CodeMakesItGo/ChickenCoopDoor/PowerSupplyVias.png

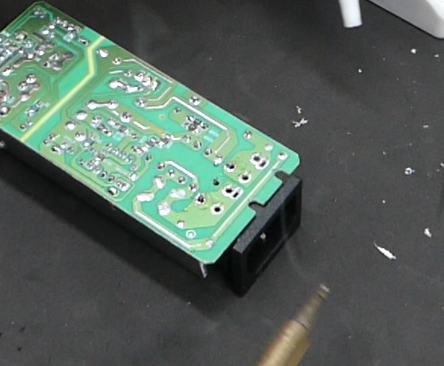
PowerSupplyVias.png
