CodeMakesItGo/ChickenCoopDoor/Garage Unit with 120v Power Connection.png

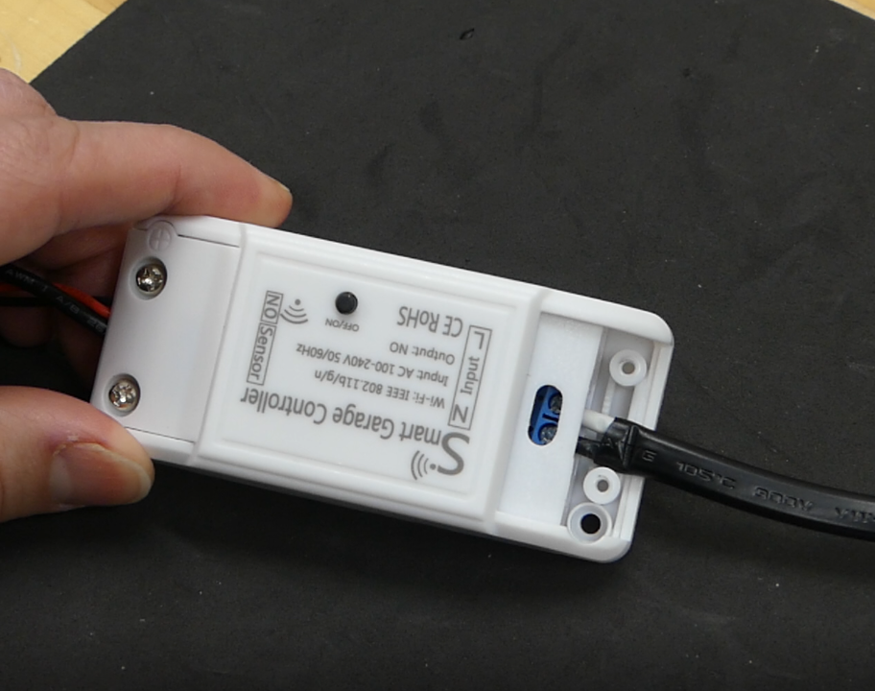
Garage Unit with 120v Power Connection.png
