CodeMakesItGo/ChickenCoopDoor/5V Relay Connections.PNG

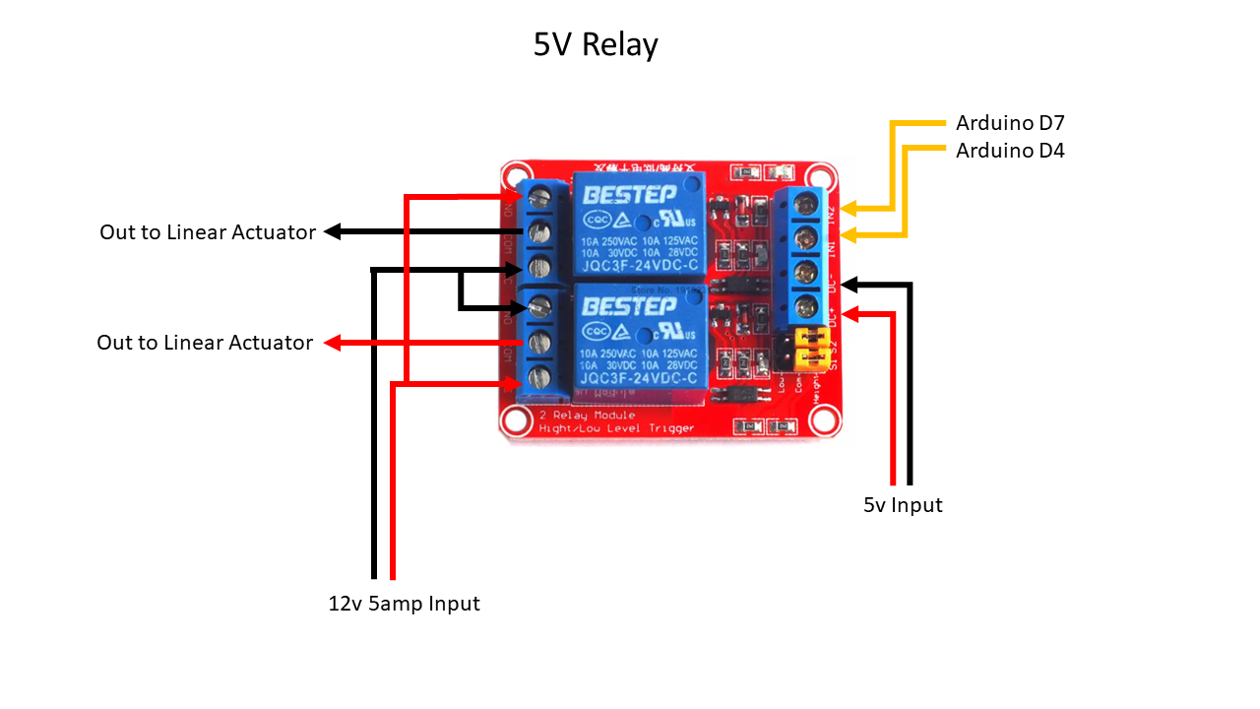
5V Relay Connections.PNG
