CodeMakesItGo/ChickenCoopDoor/5V USB Controller with 5V Relay.PNG

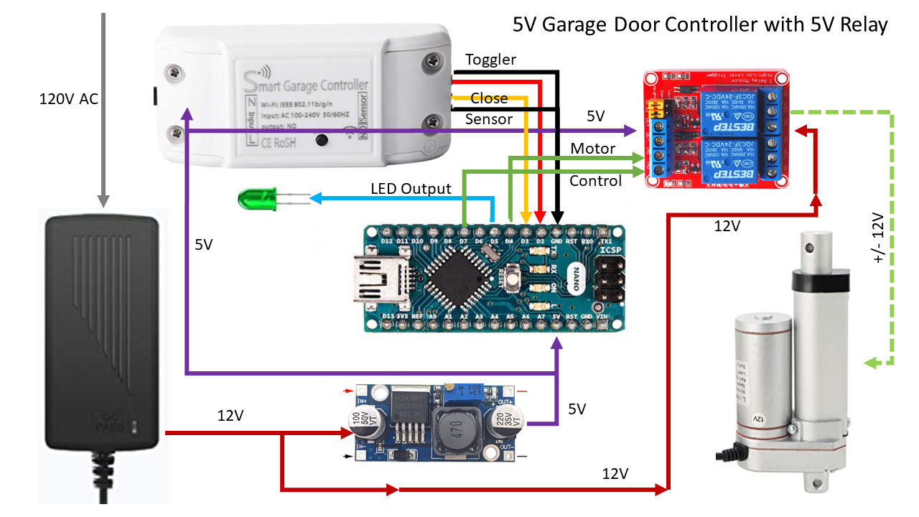
5V USB Controller with 5V Relay.PNG
