CodeMakesItGo/ChickenCoopDoor/120V Controller with 5V Relay.PNG

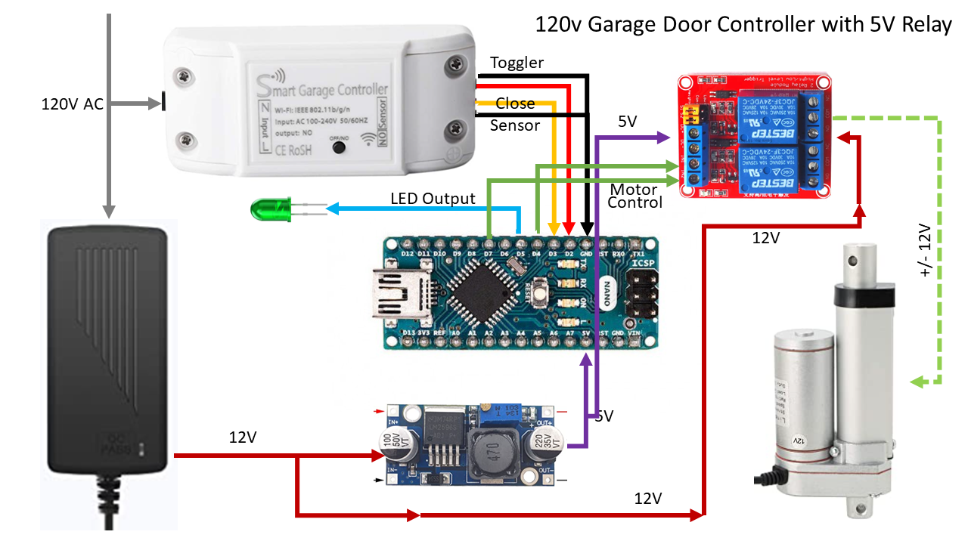
120V Controller with 5V Relay.PNG
