CodeMakesItGo/ChickenCoopDoor/Feedback sensor connection.PNG

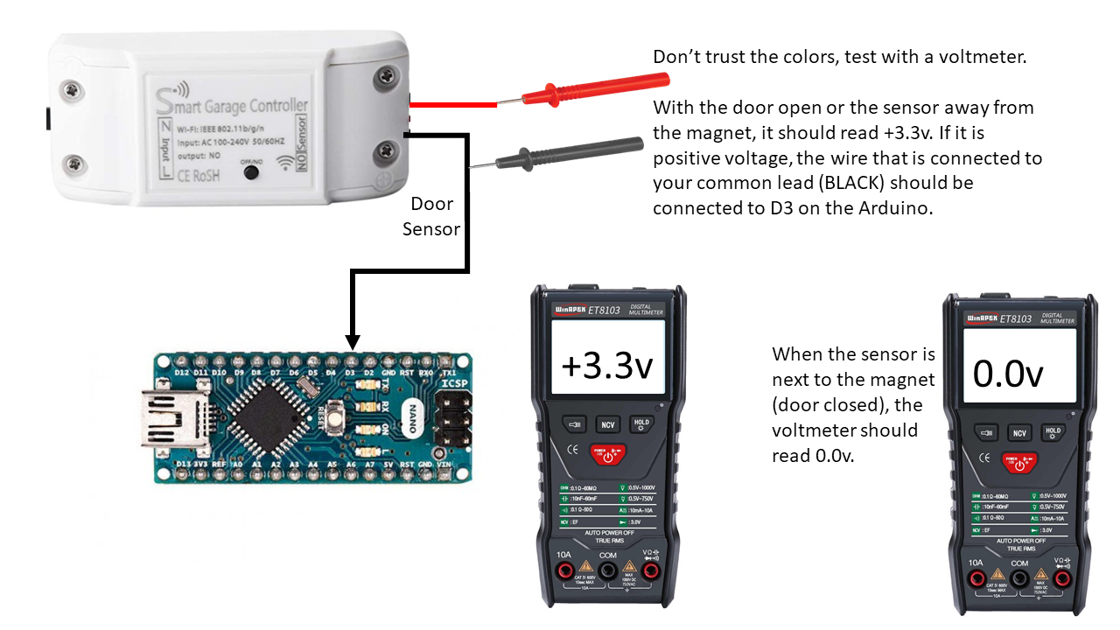
Feedback sensor connection.PNG
