CodeMakesItGo/ChickenCoopDoor/(commit log)

2021-02-02 Updated wiring diagram
    The wiring diagram in the video was wrong!! A viewer building this spotted it. Here is the updated one.
2021-03-28 Added sensor connection
2021-08-21 Updated wire diagrams
2021-08-21 Updated the voltage feedback sensor
2021-09-04 Added door output LED
2021-09-18 Updated Connections
    Fixed brown out condition when reversing actuator direction
    [chicken_coop.ino]
2021-09-18 Update Feedback sensor connection.PNG
2022-04-26 Added pulsing Status led
2022-07-22 Updated PWM max brightness
2024-10-15 added external door and power LED to PCB
2024-10-29 New program with light and door sensors
2024-10-29 New code for use with light and door sensor
2025-07-14 Updated to rev 1.7 for relay switch process and increased to 1000ms
